gabrielrodcanal/alg-machine/doc/esquema1.pdf

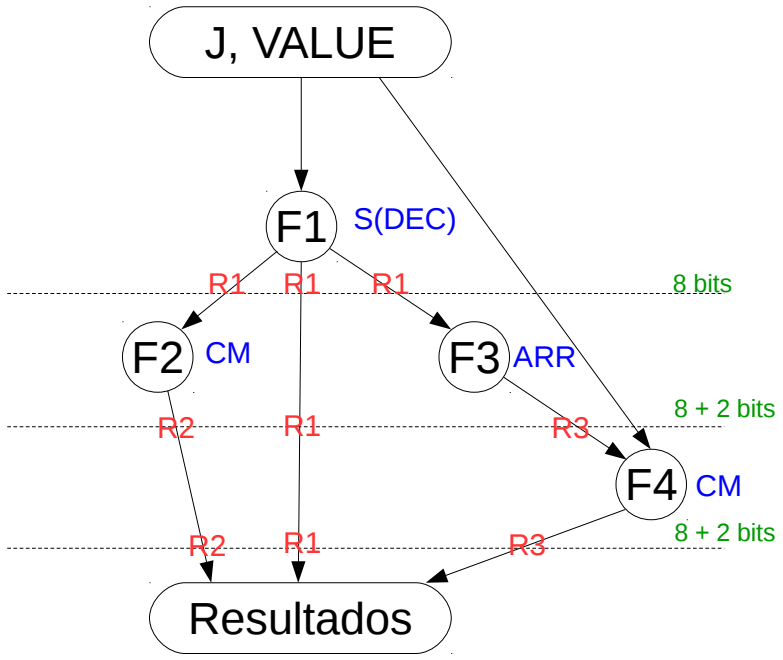
[picture p19: figure]
J, VALUE; Resultados; S(DEC); ARR; 8 bits; 8 + 2 bits
