gabrielrodcanal/alg-machine/doc/esquema2.pdf

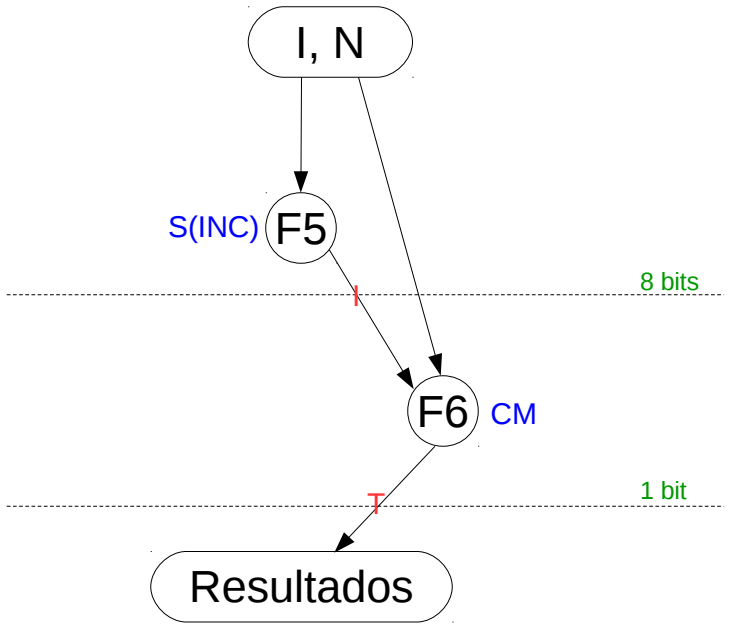
[picture p20: figure]
Resultados; S(INC); 8 bits; 1 bit
