gabrielrodcanal/alg-machine/doc/esquema1.jpg

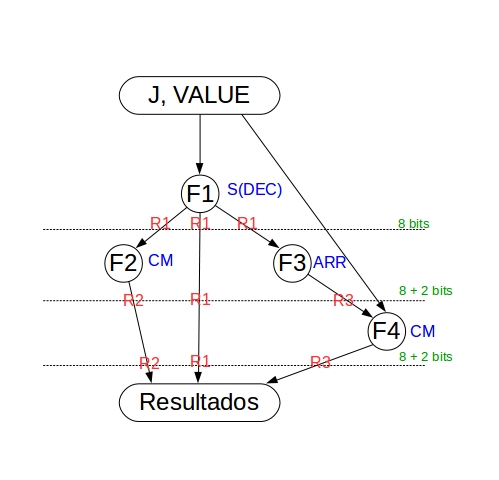
doc/esquema1.jpg
