gabrielrodcanal/alg-machine/doc/esquema2.jpg

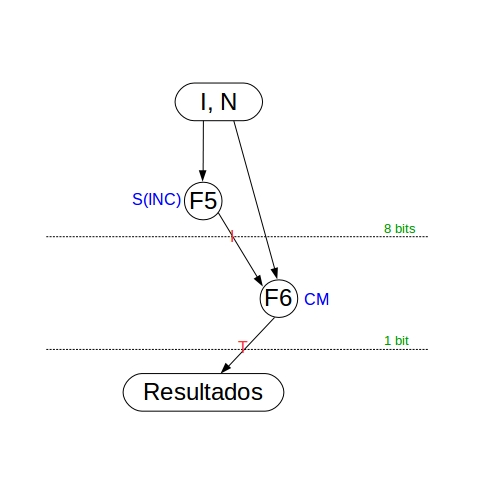
doc/esquema2.jpg
