gabrielrodcanal/alg-machine/doc/proteus-img/procesazcontrol.PNG

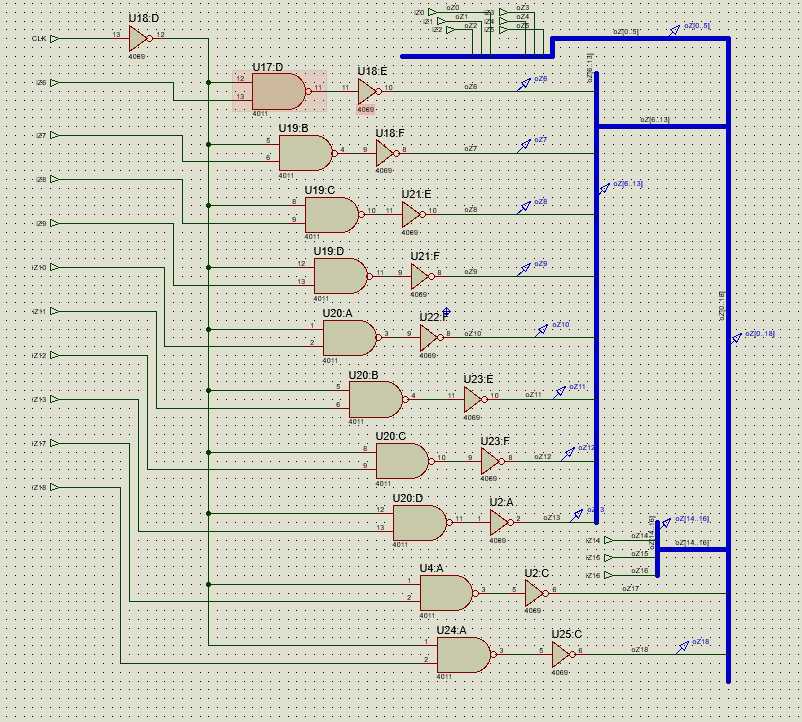
doc/proteus-img/procesazcontrol.PNG
