gabrielrodcanal/alg-machine/doc/proteus-img/ud-proceso.PNG

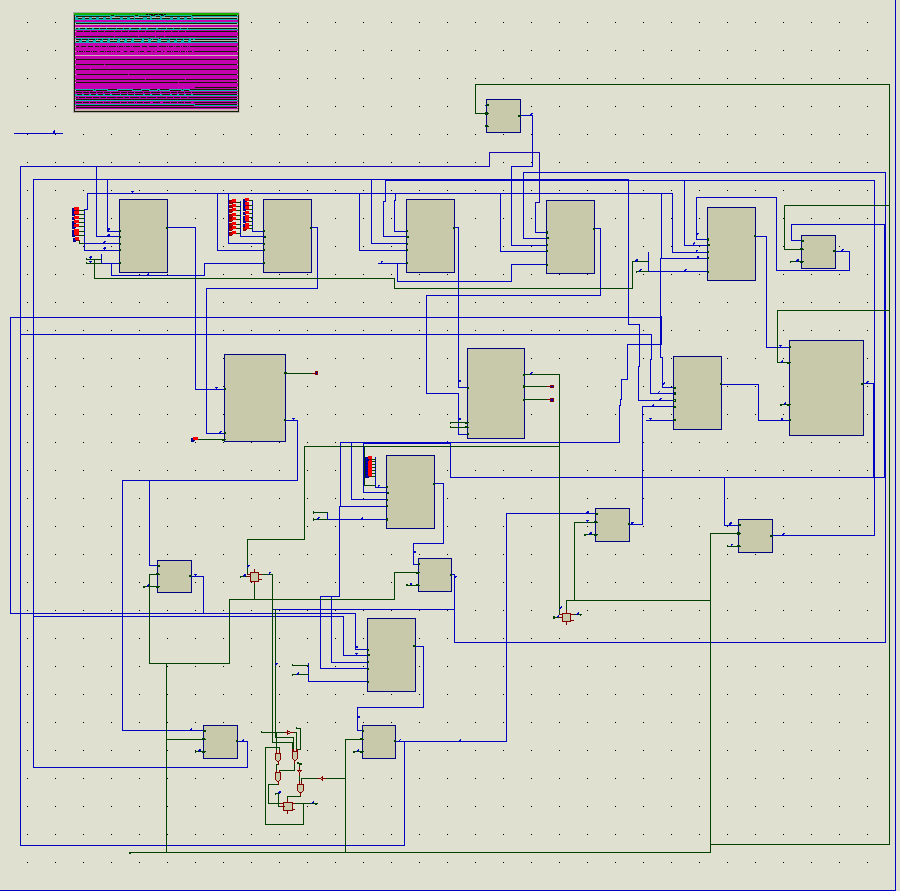
doc/proteus-img/ud-proceso.PNG
