gabrielrodcanal/alg-machine/doc/ud_control.pdf

0 0 0 | 0 | NOOP
0 0 1 | 0 | PRESET

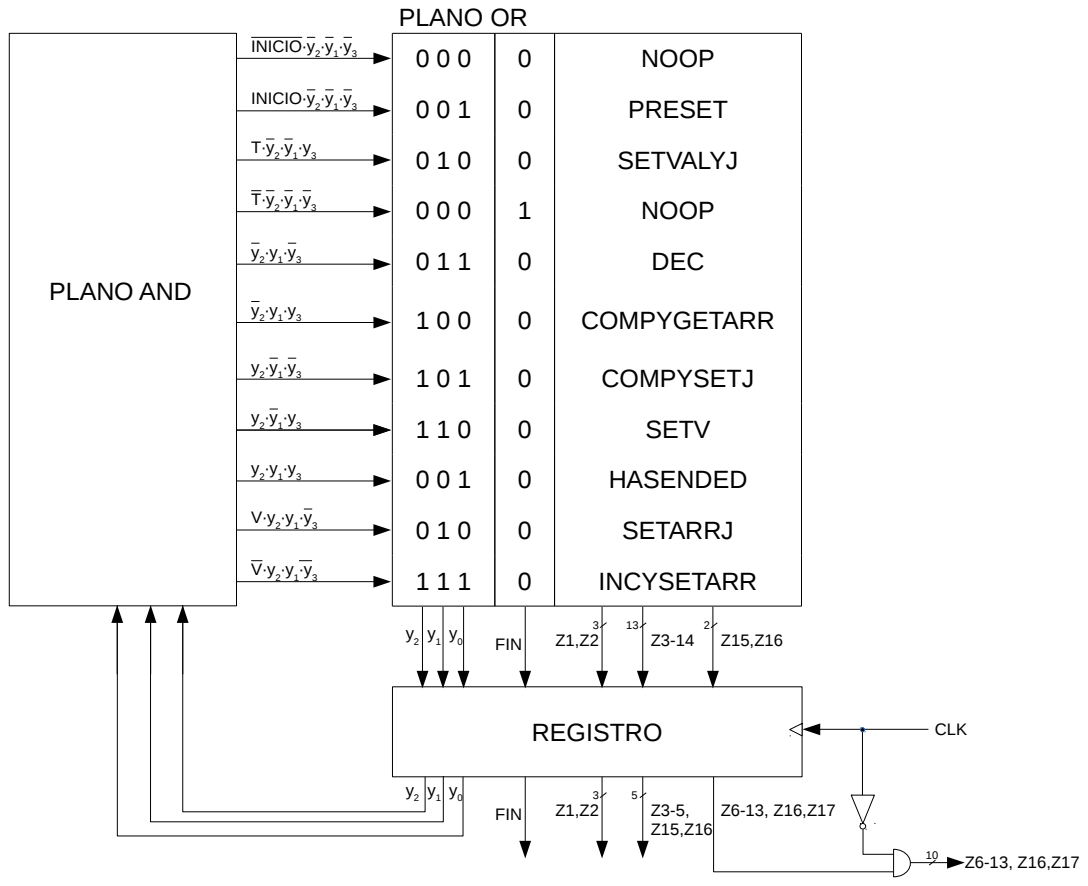
[picture p25: page 1]
SETVALYJ; NOOP; DEC; COMPYGETARR; COMPYSETJ; SETV; HASENDED; SETARRJ; INCYSETARR; INICIO·y2; PLANO AND; PLANO OR; REGISTRO; FIN; CLK
