gabrielrodcanal/alg-machine/doc/ud_proceso.pdf

N

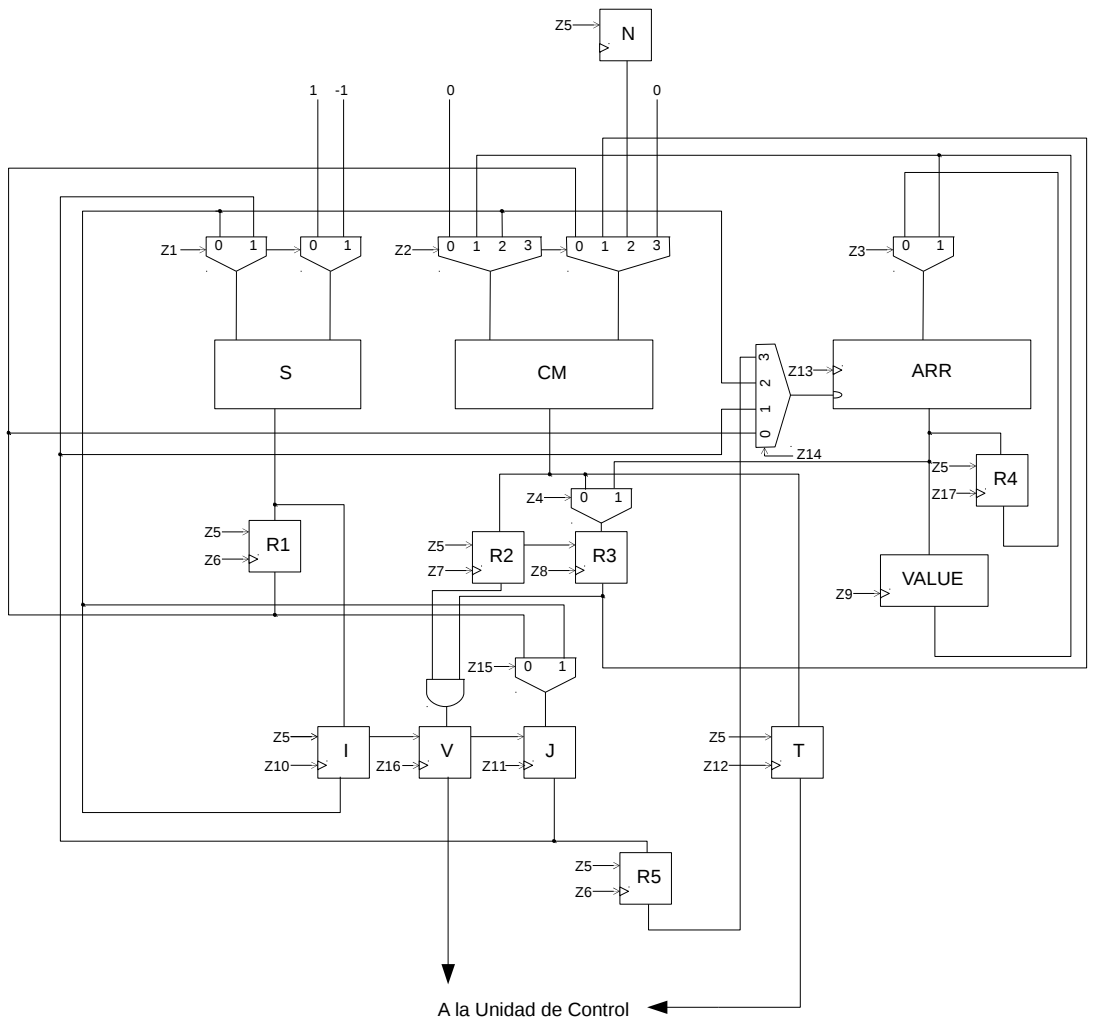
[picture p26: page 1]
VALUE; ARR

A la Unidad de Control
