gabrielrodcanal/alg-machine/(list of files, drawings)

Other design files:
insertionsort.pdsprj
